efabless/ravenna/hardware/ravenna_back.jpg

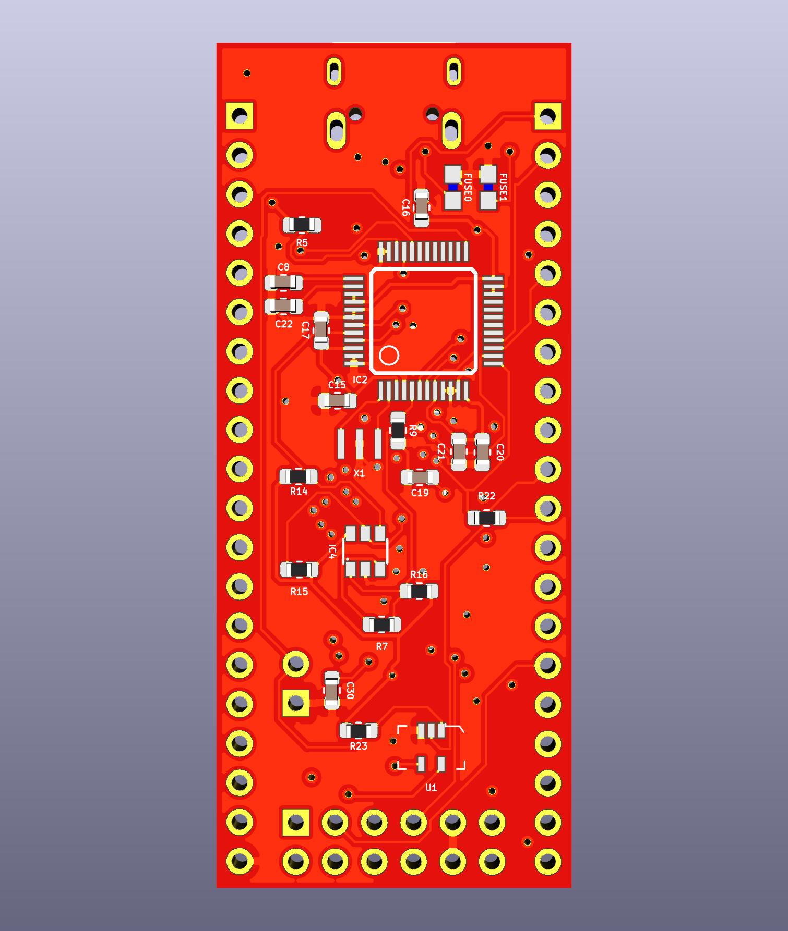
hardware/ravenna_back.jpg
