efabless/ravenna/hardware/ravenna_front.jpg

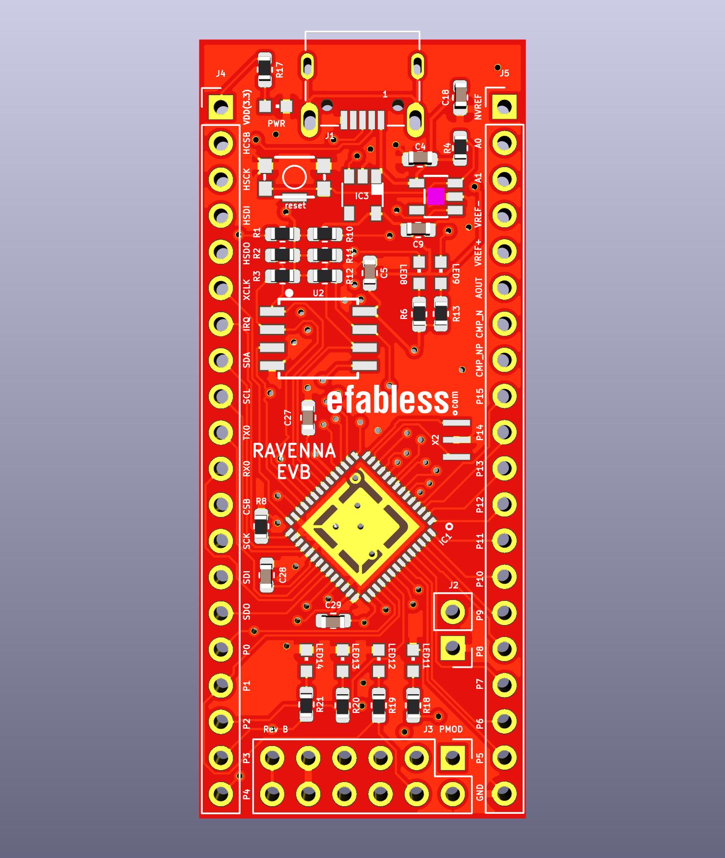
hardware/ravenna_front.jpg
