efabless/ravenna/firmware/nvram/README

This file programs the NVRAM area, then overwrites with
volatile data, then refreshes from the nonvolatile contents.
Each time the data are printed.
