efabless/ravenna/hardware/ravenna.xlsx

Reference | Quantity | Value | MPN | Vendor | Digikey PN | Part Page | Footprint
C15 C16 C17 C20 C21 C8 C22 C5 C19 C27 C28 C29 C30 | 13 | 0.1uf | LMF107B7104KAHT | Taiyo Yuden | 587-6557-1-ND | https://www.digikey.com/products/en/capacitors/ceramic-capacitors/60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 | parts and footprints:C_0603_1608Metric
C4 C9 C18 | 3 | 1uf | LMK107C6105KA-T | Taiyo Yuden | 587-4912-1-ND | https://www.digikey.com/product-detail/en/taiyo-yuden/LMK107C6105KA-T/587-4912-1-ND/6563755 | parts and footprints:C_0603_1608Metric
FUSE0 FUSE1 | 2 | PGB10100603 | PGB1010603NRHF | Littelfuse Inc. | F4239CT-ND | https://www.digikey.com/products/en?keywords=F4239CT-ND | ravenna:0603
IC1 | 1 | RAVENAQFN56 | Ravenna | Efabless |  |  | parts and footprints:QFN56
IC2 | 1 | FT232H | FT232HL-REEL | FTDI, Future Technology Devices International Ltd | 768-1101-1-ND | https://www.digikey.com/product-detail/en/ftdi-future-technology-devices-international-ltd/FT232HL-REEL/768-1101-1-ND/2614632 | ravenna:LQFP48
IC3 | 1 | MCP1755 | MCP1755T-3302E/OT | Microchip Technology | MCP1755T-3302E/OTCT-ND | https://www.digikey.com/products/en?keywords=MCP1755T-3302E%2FOTCT-ND | ravenna:SOT23-5
IC4 | 1 | 93C56 | 93C56BT-I/OT | Microchip Technology | 93C56BT-I/OTCT-ND | https://www.digikey.com/products/en?keywords=93C56BT-I%2FOTCT-ND | ravenna:SOT23-6
J1 | 1 | 629105150521 | 629105150521 | Würth Elektronik | 732-5960-1-ND | https://www.digikey.com/product-detail/en/w%C3%BCrth-elektronik/629105150521/732-5960-1-ND/5047555 | parts and footprints:629105150521
J2 | 0 | Conn_01x02_Male | 77311-118-02LF | Amphenol ICC (FCI) | 609-4434-ND | https://www.digikey.com/product-detail/en/amphenol-icc-fci/77311-118-02LF/609-4434-ND/1523689 | Connector_PinHeader_2.54mm:PinHeader_1x02_P2.54mm_Vertical
J3 | 0 | 2X6 FEMALE | PPPC062LJBN-RC | Sullins Connector Solutions | S5559-ND | https://www.digikey.com/product-detail/en/sullins-connector-solutions/PPPC062LJBN-RC/S5559-ND/776017 | Connector_PinHeader_2.54mm:PinHeader_2x06_P2.54mm_Vertical
J5 J4 | 0 | CONN_20 | 68000-220HLF | Amphenol ICC (FCI) | 609-5100-ND | https://www.digikey.com/product-detail/en/amphenol-icc-fci/68000-220HLF/609-5100-ND/4273250 | Connector_PinHeader_2.54mm:PinHeader_1x20_P2.54mm_Vertical
LED8 LED9 LED10 LED11 LED12 LED13 LED14 | 7 | LEDCHIPLED_0603 | 150060RS55040 | Würth Elektronik | 732-12015-1-ND | https://www.digikey.com/products/en?keywords=732-12015-1-ND | ravenna:CHIPLED_0603
R1 R4 R5 R8 R3 R2 R12 R11 R10 R16 R14 R15 R23 | 13 | 10K | ERJ-3EKF1002V | Panasonic Electronic Components | P10.0KHCT-ND | https://www.digikey.com/product-detail/en/panasonic-electronic-components/ERJ-3EKF1002V/P10-0KHCT-ND/198102 | parts and footprints:R_0603_1608Metric
R17 R18 R19 R20 R21 R6 R13 | 7 | 150 | RC0603FR-07150RL | Yageo | 311-150HRCT-ND | https://www.digikey.com/product-detail/en/yageo/RC0603FR-07150RL/311-150HRCT-ND/729905 | parts and footprints:R_0603_1608Metric
R22 | 1 | 0 | ERJ-3GEY0R00V | Panasonic Electronic Components | P0.0GCT-ND | https://www.digikey.com/products/en/resistors/chip-resistor-surface-mount/52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 | parts and footprints:R_0603_1608Metric
R7 | 1 | 2K 1% | ERJ-3EKF2001V | Panasonic Electronic Components | P2.00KHCT-ND | https://www.digikey.com/product-detail/en/panasonic-electronic-components/ERJ-3EKF2001V/P2-00KHCT-ND/198219 | parts and footprints:R_0603_1608Metric
R9 | 1 | 12K 1% | ERJ-3EKF1202V | Panasonic Electronic Components | P12.0KHCT-ND | https://www.digikey.com/product-detail/en/panasonic-electronic-components/ERJ-3EKF1202V/P12-0KHCT-ND/1746728 | parts and footprints:R_0603_1608Metric
RESET1 | 1 | SPST-SMD-4.6X2.8mm | KMR421G LFS | C&K | CKN10249CT-ND | https://www.digikey.com/product-detail/en/c-k/KMR421G-LFS/CKN10249CT-ND/2176500 | parts and footprints:TACTILE_SWITCH_SMD_4.6X2.8MM
U$1 | 1 | MCP1316M | MCP1316MT-20LI/OT | Microchip Technology | MCP1316MT-20LI/OTCT-ND | https://www.digikey.com/products/en?keywords=MCP1316MT-20LI%2FOTCT-ND | ravenna:SOT23-5
U1 | 1 | SN74LVC1G125DCKR | SN74LVC1G125DCKR | Texas Instruments | 296-11604-1-ND | https://www.digikey.com/products/en/integrated-circuits-ics/logic-buffers-drivers-receivers-transceivers/704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 | parts and footprints:SC-70-5
U2 | 1 | W25Q32FV | W25Q32JVSSIQ TR | Winbond Electronics | W25Q32JVSSIQCT-ND | https://www.digikey.com/products/en?keywords=W25Q32JVSSIQCT-ND | ravenna:SOIC-8
X1 | 1 | 12MHz | CSTNE12M0GH5L000R0 | Murata Electronics | 490-17947-1-ND | https://www.digikey.com/products/en/crystals-oscillators-resonators/resonators/174?k=CSTNE12M0GH5L000R0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 | parts and footprints:CSTNE12M0GH5L000R0
X2 | 0 | 6 MHz | CSTCR6M00G55-R0 | Murata Electronics | 490-5997-1-ND | https://www.digikey.com/product-detail/en/murata-electronics/CSTCR6M00G55-R0/490-5997-1-ND/3845197 | parts and footprints:CSTNE12M0GH5L000R0
X2 | 1 | 8 MHz | CSTNE8M00GH5C000R0 | Murata Electronics | 490-17961-1-ND | https://www.digikey.com/product-detail/en/murata-electronics/CSTNE8M00GH5C000R0/490-17961-1-ND/8747769 | parts and footprints:CSTNE12M0GH5L000R0
