efabless/ravenna/(threads)

Thread 1 (2020-03-22):

Ravenna PCB Issue

Mahfouz-z, 2020-03-22:
- The Foot Print for the tactile switch is missing a fifth ground pad. https://eu.mouser.com/ProductDetail/E-Switch/TL6330AF200Q?qs=sGAEpiMZZMsgGjVA3toVBKCPvIjROCDkCTtvIRblThM%3D
- There are some DRC errors for courtyards overlap.
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

jeffdi, 2020-03-22:
reolved.  thanks.

jeffdi, 2020-03-22:
resolved

Closed 2020-03-22.
