efabless/ravenna/hardware/ravenna.kicad_pcb

## KiCad design hardware/ravenna.kicad_pcb (2020-07-21)

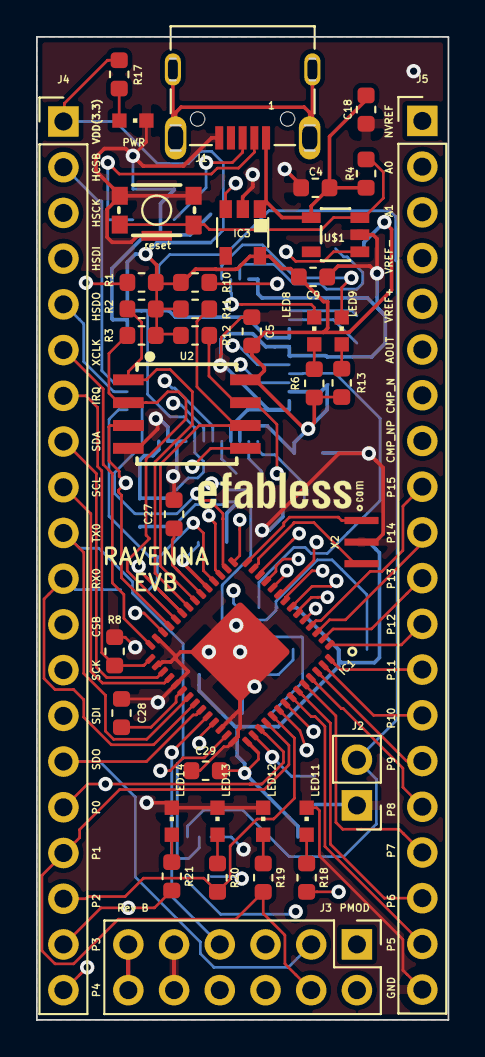
[picture p3: board ravenna.kicad_pcb from above]

Board: 4 copper layers, 22.9 x 54.6 mm, 63 parts (0 on the bottom side), 77 nets.

Parts:
C4, C9, C18: 1uf; C_0603_1608Metric
C5, C8, C15, C16, C17, C19, C20, C21, C22, C27, C28, C29, C30: 0.1uf; C_0603_1608Metric
FUSE0, FUSE1: PGB10100603; 0603
IC1: RAVENAQFN56; QFN56
IC2: FT232H; LQFP48
IC3: MCP1755; SOT23-5
IC4: 93C56; SOT23-6
J1: 629105150521
J2: Conn_01x02_Male; PinHeader_1x02_P2.54mm_Vertical
J3: 2X6 FEMALE; PinHeader_2x06_P2.54mm_Vertical
J4, J5: CONN_20; PinHeader_1x20_P2.54mm_Vertical
LED8, LED9, LED10, LED11, LED12, LED13, LED14: LEDCHIPLED_0603; CHIPLED_0603
R1, R2, R3, R4, R5, R8, R10, R11, R12, R14, R15, R16, R23: 10K; R_0603_1608Metric
R6, R13, R17, R18, R19, R20, R21: 150; R_0603_1608Metric
R7: 2K 1%; R_0603_1608Metric
R9: 12K 1%; R_0603_1608Metric
R22: 0; R_0603_1608Metric
RESET1: SPST-SMD-4.6X2.8mm; TACTILE_SWITCH_SMD_4.6X2.8MM
U1: SN74LVC1G125DCKR; SC-70-5
U2: W25Q32FV; SOIC-8
U$1: MCP1316M; SOT23-5
X1: 12MHz; CSTNE12M0GH5L000R0
X2: 6 MHz; CSTNE12M0GH5L000R0

Connections:
+5V: C4.1, C18.1, IC3.1, J1.1, R4.2, U$1.4
/ANA_0: IC1.11, J5.2
/ANA_1: IC1.10, J5.3
/AOUT: IC1.7, J5.6
/COMP_INN: IC1.6, J5.7
/COMP_INP: IC1.5, J5.8
/HK_CSB: IC1.17, IC2.16, J4.2
/HK_SDO: IC1.15, IC2.15, J4.5
/I2C_SCL: IC1.32, J3.6, J4.9
/I2C_SDA: IC1.31, J3.8, J4.8
/IRQ: IC1.29, J4.7, R8.1
/NVREF: IC1.12, J5.1
/P0: IC1.45, J3.2, J4.16, R18.2
/P1: IC1.46, J3.4, J4.17, R19.2
/P2: IC1.47, J4.18, R20.2
/P3: IC1.48, J4.19, R21.2
/P4: IC1.49, J4.20
/P5: IC1.50, J5.19
/P6: IC1.51, J5.18
/P7: IC1.52, J5.17
/P8: IC1.53, J5.16
/P9: IC1.54, J5.15
/P10: IC1.55, J5.14
/P11: IC1.56, J5.13
/P12: IC1.1, J5.12
/P13: IC1.2, J5.11
/P14: IC1.3, J5.10
/P15: IC1.4, J5.9
/RAPTOR_CS: IC1.22, R2.2, U2.1
/RAPTOR_D0: IC1.23, R10.2, U2.5
/RAPTOR_D1: IC1.24, R3.2, U2.2
/RAPTOR_D2: IC1.25, R1.2, U2.3
/RAPTOR_D3: IC1.26, R12.2, U2.7
/RAPTOR_SCK: IC1.21, R11.2, U2.6
/RX0: IC1.36, J4.11, R22.2
/RXD_HK_SDI: IC1.16, IC2.14, J4.4, U1.4
/SPI_CSB: IC1.39, J3.1, J4.12
/SPI_SCK: IC1.38, J3.7, J4.13
/SPI_SDI: IC1.41, J3.5, J4.14
/SPI_SDO: IC1.37, J3.3, J4.15
/TX0: IC1.35, J4.10, U1.2
/TXD_EN: IC2.25, J2.2, R23.1, U1.1
/TXD_HK_SCK: IC1.18, IC2.13, J4.3, R22.1
/VREF+: IC1.8, J5.5
/VREF-: IC1.9, J5.4
/XCLK: IC1.28, J4.6
GND: C4.2, C5.1, C8.1, C9.2, C15.1, C16.2, C17.2, C18.2, C19.2, C20.2, C21.2, C22.1, C27.2, C28.1, C29.1, C30.2, FUSE0.1, FUSE1.1, IC1.27, IC1.30, IC1.33, IC1.40, IC1.42, IC1.EPAD, IC2.4, IC2.9, IC2.10, IC2.11, IC2.22, IC2.23, IC2.35, IC2.36, IC2.41, IC2.42, IC2.47, IC2.48, IC3.2, IC4.2, J1.5, J2.1, J3.9, J3.10, J5.20, LED10.C, LED11.C, LED12.C, LED13.C, LED14.C, R8.2, R9.1, RESET1.3, RESET1.4, RESET1.5, U1.3, U2.4, U$1.2, X1.2, X2.2
unnamed: C8.2, IC2.37
unnamed: C22.2, IC2.38
unnamed: C27.1, IC1.20
unnamed: C28.2, IC1.34
unnamed: C30.1, IC1.44
unnamed: FUSE0.2, IC2.7, J1.3
unnamed: FUSE1.2, IC2.6, J1.2
unnamed: IC1.13, X2.1
unnamed: IC1.14, X2.3
unnamed: IC2.1, X1.1
unnamed: IC2.2, X1.3
unnamed: IC2.5, R9.2
unnamed: IC2.32, LED9.C
unnamed: IC2.33, LED8.C
unnamed: IC2.34, R5.1
unnamed: IC2.43, IC4.1, R7.1, R16.2
unnamed: IC2.44, IC4.4, R14.2
unnamed: IC2.45, IC4.5, R15.2
unnamed: IC3.3, U$1.1
unnamed: IC4.3, R7.2
unnamed: J1.SHELL, J1.SHELL1, J1.SHELL2, J1.SHELL3
unnamed: LED8.A, R6.2
unnamed: LED9.A, R13.2
unnamed: LED10.A, R17.1
unnamed: LED11.A, R18.1
unnamed: LED12.A, R19.1
unnamed: LED13.A, R20.1
unnamed: LED14.A, R21.1
unnamed: R4.1, RESET1.1, RESET1.2, U$1.3
VDD: C5.2, C9.1, C15.2, C16.1, C17.1, C19.1, C20.1, C21.1, C29.2, IC1.19, IC1.43, IC2.3, IC2.8, IC2.12, IC2.24, IC2.39, IC2.40, IC2.46, IC3.5, IC4.6, J3.11, J3.12, J4.1, R1.1, R2.1, R3.1, R5.2, R6.1, R10.1, R11.1, R12.1, R13.1, R14.1, R15.1, R16.1, R17.2, R23.2, U1.5, U2.8
