efabless/ravenna/(commit log)

2020-01-31 enhance blink led pattern
2020-02-07 added uart example
2020-02-07 uart - flush output
2020-02-24 uart - debug
2020-03-17 add hardware for pcba; gitignore
    [ravenna.kicad_pcb, ravenna.sch]
2020-03-17 schematic review updates
2020-03-19 parts libraries
    [ravenna.kicad_pcb, ravenna.sch]
2020-03-21 completed revised layout
    [ravenna.kicad_pcb, ravenna.sch]
2020-03-21 updated layout
    [ravenna.kicad_pcb]
2020-03-21 add gerbers; updated silkscreen
    [ravenna-B.Mask.gbs, ravenna-B.SilkS.gbo, ravenna-Bottom.gbl, ravenna-Edge.Cuts.gm1, ravenna-F.Mask.gts, ravenna-F.SilkS.gto, ravenna-Top.gtl, ravenna.drl]
2020-03-22 fixed gnd pad for switch; fixed courtyard overlaps;
    [ravenna-B.Mask.gbs, ravenna-B.SilkS.gbo, ravenna-Bottom.gbl, ravenna-Edge.Cuts.gm1, ravenna-F.Mask.gts, ravenna-F.SilkS.gto, ravenna-Top.gtl, ravenna.drl]
2020-03-24 uart debug
2020-04-08 add adc; gerber files updated
    [ravenna.kicad_pcb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]
2020-04-08 update parts and footprints
    [ravenna.xlsx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]
2020-04-08 adc fix
2020-04-08 adc debug
2020-04-09 i2c test
2020-06-03 debug i2c; read data exec in mem function
    [ravenna.xlsx]
2020-07-21 update rtc; add nvram; update hardware;
    [ravenna-B_Mask.gbs, ravenna-B_Paste.gbp, ravenna-B_SilkS.gbo, ravenna-Bottom.gbl, ravenna-Edge_Cuts.gm1, ravenna-F_Mask.gts, ravenna-F_Paste.gtp, ravenna-F_SilkS.gto]
